AnitaIssayeva/cosmic-ray-detector/case/detector_3d.3mf

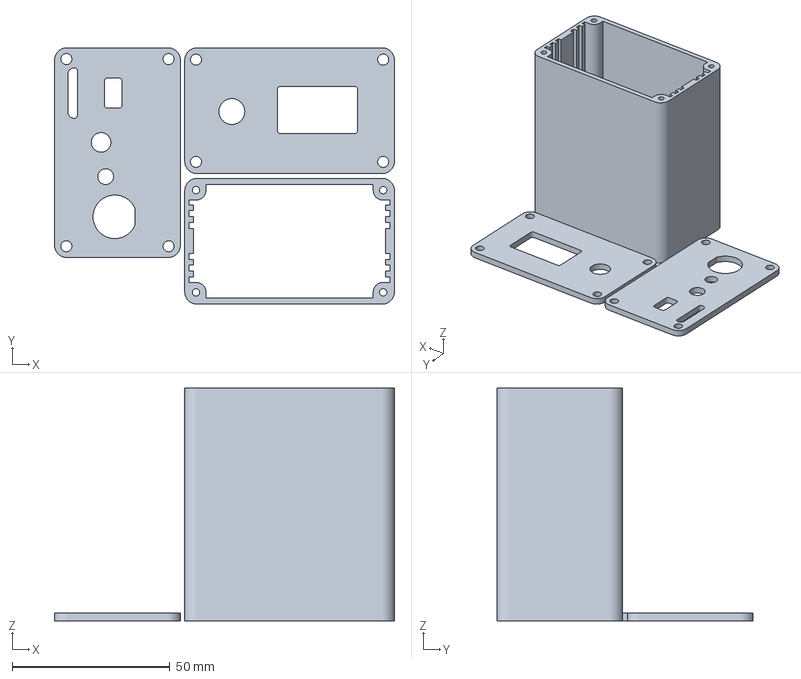
[picture p15: CAD file, 2025-01-22]
case/detector_3d.3mf
107.6 x 81.2 x 73.7 mm
