AnitaIssayeva/cosmic-ray-detector/(list of files, cad)

Other CAD files:
case/detector_3d.dxf
