AnitaIssayeva/cosmic-ray-detector/(commit log)

2026-06-30 Delete detector_3d.3mf
    I deleted the extra file
    [detector_3d.3mf]
2026-06-30 Delete detector_3d.dxf
    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
    [detector_3d.dxf]
2026-06-30 Delete case/detector_3d.stl
    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
    [detector_3d.stl]
